EvanKrall/pipad/datasheets/GPIO - Raspberry Pi Documentation_files/octocat.jpg

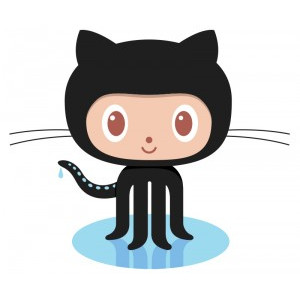
datasheets/GPIO - Raspberry Pi Documentation_files/octocat.jpg
