EvanKrall/pipad/(threads)

Thread 1 (2021-07-06):

bq25895 might negotiate high voltage USB, which would be passed through to RPi

EvanKrall, 2021-07-06:
Ideas:

- overvoltage protection on VBUS and/or PMID
- microcontroller that disables HVDCP_EN and MAXC_EN on power-up (possible race condition?)
- separate boost controller from battery (copy design from superpower-rpi)

EvanKrall, 2022-04-01:
fixed in cm4 branch; the radxa cm3 version uses the CM3's built-in battery charger (in theory)

Closed 2022-04-01.

Thread 2 (2021-07-06):

design: Flip touchscreen connectors and spread them apart

EvanKrall, 2021-07-06:
I need to mirror-image the touchscreen connectors front-to-back.

~They're also too close together by half a millimeter ish. I need to figure out exactly how far apart they need to be.~ Actually, looks like I soldered one of my connectors off-by-one.

EvanKrall, 2022-04-01:
fixed in both cm4 and radxa_cm3 branches.

Closed 2022-04-01.

Thread 6 (2021-07-06):

design: pull bq25895's OTG pin high

EvanKrall, 2021-07-06:
either with a trace or by connecting it to a microcontroller.

EvanKrall, 2021-07-21:
Only necessary if I keep using the bq25895's boost converter. If I switch to a separate boost converter to solve #1, then this isn't necessary.

Closed 2021-09-10.

Thread 7 (2021-07-06):

Assemble top of v0.0.1 prototype

EvanKrall, 2021-07-06:

EvanKrall, 2021-07-07:
I really should just pay to have boards assembled (or mostly assembled). 0402 is fiddly, tedious work.

Closed 2021-07-07.

Thread 8 (2021-07-06):

Test backlight controller

EvanKrall, 2021-07-06:
- [ ] Check open circuit voltage
- [x] Double check pinout
- [x] Test with dummy LED strings

EvanKrall, 2021-07-09:
Can't easily test open-circuit voltage because the tps61176 will shut down if it detects no LED strings.

EvanKrall, 2021-07-10:
Yep, the problem was the open circuit voltage not being high enough 🤦 https://hackaday.io/project/177256-put-a-raspberry-pi-cm4-into-an-original-ipad/log/195169-first-light-testing-and-fixing-the-backlight-controller

Closed 2021-07-10.

Thread 9 (2021-07-06):

design: wire up SDIO, power, i2s for wifi/bt controller

EvanKrall, 2021-07-06:

EvanKrall, 2021-09-10:
Honestly I should probably just get some extension cables for the wifi antennas and just get a cm4 with wifi/bt. Would take less effort and end up with faster wifi anyway.

Closed 2021-09-10.

Thread 12 (2021-07-07):

test new audio codec revision

EvanKrall, 2021-07-07:
Refer back to my project log about testing the last codec revision.

EvanKrall, 2021-09-18:
Some fun with the dtoverlay: https://www.raspberrypi.org/forums/viewtopic.php?p=1914969#p1914969

Today's task is to figure out why I'm not getting audio output. I can see i2s data being sent by the pi, and the headphone pins jump to some nonzero DC offset (which is odd... the whole point of switching to this codec was to get ground-centered headphone output.)

I think my plan here is to look at the datasheet, figure out what registers need to be set to what value to get output on HPL/HPR or LOL/LOR, and then see which settings in alsamixer affect those registers.

EvanKrall, 2021-09-18:
I think I forgot to connect ring2/GND_sense to ground.

EvanKrall, 2021-09-18:
I should rearrange the decoupling caps to put a 10uF near pin 39 (DVDD_CP).

EvanKrall, 2021-09-18:
oh, boo, the tlv320aic32x4 driver doesn't seem to know how to configure the charge pump in the 3206.

EvanKrall, 2021-09-18:
boo, it also doesn't seem to know how to configure the headset detection feature, page 0 reg 67. (2.11.1 Headset Detection in https://www.ti.com/lit/an/slaa463b/slaa463b.pdf)

EvanKrall, 2021-09-21:
Various registers to check:

- [ ] page 0 reg 4: xxxx0x11: MCLK or BCLK is PLL input; PLL clock is CODEC_CLKIN.
- [ ] page 0 reg 5: 1xxxxxxx: PLL is powered up
- [ ] page 0 reg 0x1b: 00xx00xx: i2s interface, bclk and wclk are inputs.
- [ ] page 0 reg 0x1d: xxx0xxxx: `0: No Loopback` (as opposed to `1: Stereo ADC output is routed to Stereo DAC input`)
- [ ] page 0 reg 0x25: 110x110x or 101x101x: LDAC/RDAC powered up and either LOL/LOR or HPL/HPR powered up.
- [ ] page 0 reg 0x2a: 00000000
- [ ] page 0 reg 0x2c: 000x00xx: no over-current problems. (Ignore headset insertion)
- [ ] page 0 reg 0x3f: 110101xx: DAC channels powered up, not disabled
- [ ] page 0 reg 0x40: x00000xx: auto mute disabled; neither channel muted
- [ ] page 0 reg 0x41: 0xxxxxxx: gain >= 0db (or at least not super low)
- [ ] page 0 reg 0x42: 0xxxxxxx: gain >= 0db (or at least not super low)
- [ ] page 1 reg 0x01: xxxxxx10 for charge pump (possibly not required)
- [ ] page 1 reg 0x02: xxxx11xx: analog blocks enabled; headphone driver powered up
- [ ] page 1 reg 0x09: xx110000 or xx001100: HPL/HPR are powered up and LOL/LOR/MAL/MAR are powered down, or LOL/LOR are powered up and HPL/HPR/MAL/MAR are powered down.
- [ ] page 1 reg 0x0c: xxxx1000: only left channel DAC is routed to HPL.
- [ ] page 1 reg 0x0d: xxx0100x: only right channel DAC is routed to HPR.
- [ ] page 1 reg 0x0e: xxx01x00: only left channel DAC is routed to LOL.
- [ ] page 1 reg 0x0f: xxxx1x0x: only right channel DAC is routed to LOR.
- [ ] page 1 reg 0x10: x0xxxxxx: HPL not muted.
- [ ] page 1 reg 0x11: x0xxxxxx: HPR not muted
- [ ] page 1 reg 0x12: x0xxxxxx: LOL not muted
- [ ] page 1 reg 0x13: x0xxxxxx: LOR not muted
- [ ] page 1 reg 0x16: x1110010: IN1L to HPL muted
- [ ] page 1 reg 0x17: x1110010: IN1R to HPR muted
- [ ] page 1 reg 0x18: xx101000 (MAL muted)
- [ ] page 1 reg 0x19: xx101000 (MAR muted)
- [ ] page 1 reg 0x3f: 11111111
- [ ] page 1 reg 0x7d: xxx1xxxx: enable ground-centered mode

Experiments:

- page 0 reg 0x1d: set d5 high: `Audio Data in is routed to Audio Data out`. See if it sends us valid data back.
- page 0 reg 0x47: generate a beep on left channel
- Maybe try configuring MFP5 or MISO or DOUT to pass CLKOUT to see if we have a valid clock internally?

EvanKrall, 2021-09-25:
I finally got audio by setting page 0 reg 0x04 to 0x01 (BCLK is CODEC_CLKIN), among some other settings.

By setting DOUT to CLKOUT, and CDIV_CLKIN to PLL_CLK, I could see that the PLL was not generating a clock.

EvanKrall, 2021-11-04:
with this script, I can get a steady 4xBCLK out of the PLL:

```
./tlv320aic32x6_set_reg.sh 0 0x04 0x07   # D6=0 low PLL clock range (?); D3..2 = 01 BCLK pin is input to PLL; D1..0 = 11: PLL clock is CODEC_CLKIN

# Page 77 in slaa463b.pdf
# PLL_CLK = (PLL_CLKIN * R * J.D) / P

./tlv320aic32x6_set_reg.sh 0 0x05 0x91  # PLL enabled (D7), configure P (D6..4) = 1 and R (D3..0) = 1 - page 96
./tlv320aic32x6_set_reg.sh 0 0x06 0x04  # PLL parameter J = 4
./tlv320aic32x6_set_reg.sh 0 0x07 0x00; ./tlv320aic32x6_set_reg.sh 0 0x08 0x00  # PLL parameter D = 0

# DOUT is CLKOUT
./tlv320aic32x6_set_reg.sh 0 0x35 0x16
# CLKOUT is PLL
./tlv320aic32x6_set_reg.sh 0 0x19 0x03
# CLKOUT powered up, divider = 1
./tlv320aic32x6_set_reg.sh 0 0x1A 0x81
```

There's a lot of white noise on the output, but it does work.

EvanKrall, 2021-11-04:
I think I left the headphone connector's ground pin (GND_SENSE) ungrounded. I wonder if this is why it seems to be also swinging around with the output signal, and things seem to get louder when one channel is muted.

EvanKrall, 2021-11-07:
Played around with enabling the charge pump tonight:

```

#####################################################
# Enabling the charge pump and ground-centered mode #
#####################################################

# To turn on the charge pump circuit, program Page 1, Register 1, D1:0 to “10”. When the charge pump
# circuit is disabled, VNEG acts as a ground terminal, allowing unipolar configuration of the headphone
# amps. By default, the charge pump is disabled.
./tlv320aic32x6_set_reg.sh 1 0x01 0x02  # D1-D0 = 10: Power Up Charge Pump with Internal Oscillator Clock (nom. 8MHz)

# The switching rate of the charge pump can be controlled
# by Page 1, Register 124, D3:0. Because the charge pump can demand significant inrush currents from the
# supply, it is important to have a capacitor connected in close proximity to the DVdd_CP and DVss_CP
# pins of the device. At 500kHz clock rate this requires approximately a 10μF capacitor. The ESR and ESL
# of the capacitor must be low to allow fast switching currents.
./tlv320aic32x6_set_reg.sh 1 0x7c 0x00  # Charge Pump Clock Divide Control = 64

# The ground-centered mode of operation is enabled by configuring Page 1, Reg 125, D4 after enabling the
# charge-pump.
./tlv320aic32x6_set_reg.sh 1 0x7d 0x13  # Enable Ground Centered Mode for Headphone Drivers; Output Power Rating is 100%; DC Offset Correction for all possible signal routings for HPL and HPR
```

I'm seeing significant droop on AVDD and DVDD_CP when audio levels get high; I may need to bump the size of the capacitors. In particular, slaa463b says I should have a 10uF cap on DVDD_CP, but I have 0.1uF.

Earlier in the day (when I was not using ground-centered mode), I had compared left and right channels against each other with an XY chart; this showed significant correlation between the two when playing silence. (With an interesting banding pattern which I think is due to dithering applied by the DAC.) I should do this again in ground-centered mode.

I should also try to measure the droop on the various Vcc pins.

EvanKrall, 2021-11-08:
By playing some white noise and looking at the FFT with my oscilloscope, it appears that the frequency response of the output drops off significantly from about 2.4kHz to 2.7kHz. I think I need to take a look at the various user-defined filters (slaa463b, page 44 and onwards).

I'm also still getting a lot of broad-spectrum noise mixed with my output signal. I'd like to get to the bottom of that. Based on how it looks on my scope (quantized), I think it may be added by codec as dithering, to reduce quantization error.

Thread 13 (2021-07-07):

design: wrong footprint on FSA2275

EvanKrall, 2021-07-07:
SnapEDA has the wrong footprint and I forgot to validate it before using.

Closed 2021-07-21.

Thread 14 (2021-07-07):

test touchscreen controller

EvanKrall, 2021-07-07:
- [ ] check if it enumerates on i2c
- [ ] write device tree overlay
- [ ] see if connectors can be inserted upside down (to work around #2 )
- [ ] ???

EvanKrall, 2022-04-03:
I need to wire up the INT pin to a GPIO :(

this is gonna be a fun bodge.

Thread 15 (2021-07-07):

test LVDS controller

EvanKrall, 2021-07-07:
- [ ] see if it enumerates on i2c
- [ ] Write device tree overlay
- [ ] figure out mode line?
- [ ] ???

EvanKrall, 2021-08-06:
For posterity, my attempt at a kernel patch to drive this thing:

```
diff --git a/drivers/gpu/drm/panel/panel-simple.c b/drivers/gpu/drm/panel/panel-simple.c
index 204674fccd64..eb1a5950247c 100644
--- a/drivers/gpu/drm/panel/panel-simple.c
+++ b/drivers/gpu/drm/panel/panel-simple.c
@@ -2570,15 +2570,15 @@ static const struct panel_desc lg_lp079qx1_sp0v = {
 };

 static const struct drm_display_mode lg_lp097qx1_spa1_mode = {
-       .clock = 205210,
-       .hdisplay = 2048,
-       .hsync_start = 2048 + 150,
-       .hsync_end = 2048 + 150 + 5,
-       .htotal = 2048 + 150 + 5 + 5,
-       .vdisplay = 1536,
-       .vsync_start = 1536 + 3,
-       .vsync_end = 1536 + 3 + 1,
-       .vtotal = 1536 + 3 + 1 + 9,
+       .clock = 205210,  // KHz
+       .hdisplay = 2048,  // Active
+       .hsync_start = 2048 + 150,  // Active + HFP
+       .hsync_end = 2048 + 150 + 5, // Active + HFP + Width-Active
+       .htotal = 2048 + 150 + 5 + 5, // Active + HFP + Width-Active + HBP
+       .vdisplay = 1536, // Active
+       .vsync_start = 1536 + 3, // Active + VFP
+       .vsync_end = 1536 + 3 + 1, // Active + VFP + Width-Active
+       .vtotal = 1536 + 3 + 1 + 9, // Active + VFP + Width-Active + VBP
 };

 static const struct panel_desc lg_lp097qx1_spa1 = {
@@ -3889,6 +3889,30 @@ static const struct drm_display_mode arm_rtsm_mode[] = {
        },
 };

+
+static const struct drm_display_mode lg_lp097x02_slq1_mode = {
+       .clock = 100030,  // KHz
+       .hdisplay = 1024,  // Active
+       .hsync_start = 1024 + 260,  // Active + HFP
+       .hsync_end = 1024 + 260 + 320, // Active + HFP + Width-Active
+       .htotal = 1024 + 260 + 320 + 480, // Active + HFP + Width-Active + HBP
+       .vdisplay = 768, // Active
+       .vsync_start = 768 + 16, // Active + VFP
+       .vsync_end = 768 + 16 + 10, // Active + VFP + Width-Active
+       .vtotal = 768 + 16 + 10 + 6, // Active + VFP + Width-Active + VBP
+};
+
+static const struct panel_desc lg_lp097x02_slq1 = {
+       .modes = &lg_lp097qx1_spa1_mode,
+       .num_modes = 1,
+       .size = {
+               .width = 210,
+               .height = 164,
+       },
+};
+
+
+
 static const struct panel_desc arm_rtsm = {
        .modes = arm_rtsm_mode,
        .num_modes = 1,
@@ -4300,6 +4324,9 @@ static const struct of_device_id platform_of_match[] = {
        }, {
                .compatible = "winstar,wf35ltiacd",
                .data = &winstar_wf35ltiacd,
+       }, {
+               .compatible = "lg,lp097x02-slq1",
+               .data = &lg_lp097x02_slq1,
        }, {
                /* Must be the last entry */
                .compatible = "panel-dpi",
```

I'm roughly following https://github.com/anholt/linux/wiki/Raspberry-Pi-and-other-MIPI-DSI-display-panels , though I'm first starting with `panel-simple.c` even though I have a bridge chip and it recommends to follow the `panel-raspberrypi-touchscreen.c` example.

EvanKrall, 2021-08-06:
oh, sweet, someone got support for the sn65dsi83 into the linux kernel a few months ago: https://github.com/torvalds/linux/blob/master/drivers/gpu/drm/bridge/ti-sn65dsi83.c

I guess I'll cherry-pick this.

EvanKrall, 2021-08-06:
> Only RGB888 pixel format is implemented, the
> LVDS666 is not supported, but could be added if needed.

bummer

EvanKrall, 2021-08-22:
I have this dtoverlay which loads the ti-sn65dsi83 driver:

```
/dts-v1/;
/plugin/;

/ {
    compatible = "brcm,bcm2835";
    fragment@0 {
        target-path = "/";
        __overlay__ {
            vdd_panel: fixedregulator {
                regulator-boot-on;
                compatible = "regulator-fixed";
                regulator-name = "lvds18";
                regulator-min-microvolt = <1800000>;
                regulator-max-microvolt = <1800000>;
                gpio = <&gpio 26 0>;
                startup-delay-us = <70000>;
                enable-active-high;
                vin-supply = <&vdd_3v3_reg>;
            };

            lcd_bl: backlight {
                compatible = "pwm-backlight";
                pwms = <&pwm 0 200000>;
                brightness-levels = <0 6 8 12 16 24 32 40 48 64 96 128 160 192 224 255>;
                default-brightness-level = <6>;
                power-supply = <&vdd_3v3_reg>;
                enable-gpios = <&gpio 13 0>;
                status = "okay";
            };

            panel_rgb: panel {
              compatible = "lg,lp097x02-slq1";
              // compatible = "koe,tx31d200vm0baa";
              power-supply = <&vdd_panel>;
              // backlight = <&lcd_bl>;
              status = "okay";
              port {
                panel_lvds_in: endpoint {
                  remote-endpoint = <&bridge_lvds_port>;
                };
              };
            };
        };
    };

    fragment@1 {
        target = <&i2c1>;
        __overlay__ {
            #address-cells = <1>;
            #size-cells = <0>;
            status = "okay";

            sn65dsi83_bridge: bridge@2d {
                compatible = "ti,sn65dsi83";
                reg = <0x2d>;
                status = "okay";
                enable-gpios = <&gpio 5 0>;
                power-supply = <&vdd_panel>;

                ports {        
                    #address-cells = <1>;
                    #size-cells = <0>;
                    port@0 {
                        reg = <0>; // TODO: double-check
                        bridge_dsi_port: endpoint {
                            data-lanes = <1 2>;
                            remote-endpoint = <&dsi_out_port>;
                        };
                    };

                    port@2{
                        reg = <2>;
                        bridge_lvds_port: endpoint {
                            remote-endpoint = <&panel_lvds_in>;
                        };
                    };
                };
            };
        };
    };

    fragment@2 {
        target = <&dsi1>;
        __overlay__ {
            compatible = "brcm,bcm2711-dsi1";
            status = "okay";
            port {
                dsi_out_port: endpoint {
                    remote-endpoint = <&bridge_dsi_port>;
                };
            };
        };
    };
};
```

I've got two problems at the moment:
1. My backlight lights up, but I don't have any entries under /sys/class/backlight
2. The screen is black, and at boot I'm getting the error message ```[    5.403630] sn65dsi83 1-002d: failed to lock PLL, ret=-110```

EvanKrall, 2021-08-22:
I've switched over to the CM4IO using the 22-pin to 15-pin FFC meant for the CSI port, which I think should put clock and data lanes where my board expects them.

Now I'm getting basically this exact error: https://www.raspberrypi.org/forums/viewtopic.php?p=1860828&sid=ad26a9c56f475f1c54610b6eac4ca59f#p1860828

```
[    5.325798] Bogus possible_crtcs: [ENCODER:31:DSI-31] possible_crtcs=0x0 (full crtc mask=0x1)
```

Thread 17 (2021-07-09):

design: don't need to run VCC3.3 on F.Cu

EvanKrall, 2021-07-09:
there's a long 0.5mm VCC3.3 trace on the front layer going up to the gt9113 and down to the tca9802 near the ALS port. There's no need for that - we have VCC3.3 on In1 near both of those.

EvanKrall, 2021-07-21:
fixed sometime between 19297b17f33d9973a65e6c52b8320bec698a0743 and 6ebf38a58aa911a66509f7bd489c938d12b0aee5

Closed 2021-07-21.

Thread 18 (2021-07-11):

design: prototype board DSI connector has i2c on wrong pins

EvanKrall, 2021-07-11:
I've got sda on 13 and scl on 14, but it should be 11 for scl, 12 for sda I think?

EvanKrall, 2021-07-12:
Also seems backwards.

EvanKrall, 2022-04-01:
irrelevant now that I've redesigned the boards for cm4/radxa cm3

Closed 2022-04-01.

Thread 20 (2021-07-18):

design: add M.2 slot for NVME drive

EvanKrall, 2021-07-18:

EvanKrall, 2021-07-22:
https://global.kyocera.com/prdct/electro/product/pdf/6411.pdf kyocera has a 2.25mm socket: https://www.digikey.com/en/products/detail/246411067101894B/1253-1602-1-ND/5814321?itemSeq=371692007

EvanKrall, 2021-07-22:
oops I probably would want the M key socket, not the B key. (Even though the SN520 I bought is B+M keyed, most NVMe drives are only M key.)

https://www.digikey.com/en/products/detail/kyocera-international-inc-electronic-components/246411067101894M/5814311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

EvanKrall, 2021-07-22:
https://github.com/mfolejewski/MirkoPC/blob/81a24fadfe165a523ffb9167838d34fb3440f881/REV1.1/MirkoPC_V1R2_Schematic_20210507.pdf Sheet 8 of 17 shows the schematic for the M.2 connector on the MirkoPC, which has well-tested NVMe boot capability.

EvanKrall, 2021-07-22:
The MirkoPC provides its own 3.3V rail for the NVMe drive. Probably a wise choice - the SN520 claims to use up to 3W (1A), but I think other drives might be able to pull more.

EvanKrall, 2021-07-22:
Jeff Geerling's experience with the SN520: https://github.com/geerlingguy/raspberry-pi-pcie-devices/issues/90

EvanKrall, 2021-08-31:
The next challenge is where to find the solder-down standoffs. I think this is the appropriate standard to follow (from the m.2 specification):
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

EvanKrall, 2021-08-31:
I think this is the right standoff/nut: https://www.mouser.com/ProductDetail/JAE-Electronics/SM3ZS067U215-NUT1-R2500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

EvanKrall, 2022-04-01:
this is added in both the cm4 and radxa_cm3 branches

Closed 2022-04-01.

Thread 22 (2022-04-01):

Figure out what's up with the Radxa CM3 battery charger circuitry

EvanKrall, 2022-04-01:
- If I have a battery connected, do I need to power the 5v inputs?
- how does the USB_OTG0_VBUSDET pin work?
- Can the CM3 actually charge a battery from USB?
- Can the CM3 actually run from battery?
- Can it handle hot plugging USB in and out?

Thread 24 (2022-06-27):

max16150 times out before nEXTRST goes high

EvanKrall, 2022-06-27:
the MAX16150 I'm using to handle the power button logic gives you 64ms for its `~CLR` line to go high before it gives up and shuts off the power again -- the CM4's nEXTRST line doesn't go high soon enough.

best ways I can think of to work around this:

- Use a voltage divider to bring 5v down to 3.3V, then also wire a GPIO to this 3.3V node. Use the [gpio-poweroff](https://www.kernel.org/doc/Documentation/devicetree/bindings/power/reset/gpio-poweroff.txt) dtoverlay to pull that GPIO low on shutdown.
- check whether the 3.3V or 1.8V lines go high soon enough, use those instead
- 555 timer or similar in one-shot mode, pulling the ~CLR pin high for longer?

Thread 25 (2022-06-27):

Wire nRPIBOOT to a button, figure out how to use nRPIBOOT as GPIO

EvanKrall, 2022-06-27:
I'm pretty sure I saw something that suggested that nRPIBOOT is just a regular GPIO internally, so we can kill two birds with one stone by wiring nRPIBOOT to a button (maybe volume down?)

- have a button that allows us to force rpiboot mode
- free up a GPIO for other uses (e.g. #24)

EvanKrall, 2022-06-27:
https://www.alexwhittemore.com/raspberry-pi-cm4-using-nrpi_boot/

Thread 28 (2022-09-08):

(Feature Request) Support for Radxa CM5

kerta1n, 2022-09-08:
Hello, with the upcoming [CM5](https://www.cnx-software.com/2022/09/08/radxa-cm5-rockchip-rk3588s-module-raspberry-pi-cm4/) board with a RK3588S (which is an Octa-core CPU), would all of the I/O on this PCB be compatible if someone wants to use this as a faster replacement to the RPi CM4?
edit: spelling mistake

EvanKrall, 2022-09-08:
In theory, yes, as long as the pins are in compatible locations.

I'm using the majority of the pins as low speed GPIO (interrupts and enable pins and such), I wouldn't be too concerned with those.

the special-purpose pins I'm using are:
- i2c
- I2s
- PWM (for LCD backlight)
- PCIe, but this is optional if you use built-in eMMC
- DSI
- USB

I do also have a branch (radxa_cm3) specifically designed for the Radxa CM3, which takes advantage of the fact that the CM3 can output LVDS signals directly, and avoids the need for the DSI-LVDS bridge. It doesn't look like the CM5 can do LVDS, so one would need to start from the cm4 branch.

Also it looks like the CM5 doesn't have wifi, so I'd need to figure out the iPad's built in wifi chip to have networking. (Currently I'm just relying on the cm4's built-in wifi)

If you're planning on ordering a copy of this board, I wouldn't really recommend it. It's very much a work in progresss. I've still got several issues to work out, the biggest of which is getting the screen to work. I've been posting updates to https://hackaday.io/project/177256-put-a-raspberry-pi-cm4-into-an-original-ipad (but I'm currently stuck on getting the LVDS bridge to cooperate)

kerta1n, 2022-09-12:
That makes a lot more sense. Thank you!

Closed 2022-09-12.

Thread 29 (2023-04-08):

NVMe slot not working

EvanKrall, 2023-04-08:
```
meatmanek@cm4:/sys/bus/pci$ dmesg | grep pcie
[    5.270094] calling  brcm_pcie_driver_init+0x0/0x30 @ 1
[    5.275937] brcm-pcie fd500000.pcie: host bridge /scb/pcie@7d500000 ranges:
[    5.283029] brcm-pcie fd500000.pcie:   No bus range found for /scb/pcie@7d500000, using [bus 00-ff]
[    5.292278] brcm-pcie fd500000.pcie:      MEM 0x0600000000..0x063fffffff -> 0x00c0000000
[    5.300556] brcm-pcie fd500000.pcie:   IB MEM 0x0000000000..0x003fffffff -> 0x0400000000
[    5.629281] brcm-pcie fd500000.pcie: link down
[    5.633953] initcall brcm_pcie_driver_init+0x0/0x30 returned 0 after 350140 usecs
```

[this forum post](https://forums.raspberrypi.com/viewtopic.php?p=2065042#p2065042) suggests that this is likely a PCIe connection issue.

I had discovered that my TX and RX lanes were swapped, so I made an interposer board that swaps them, but this didn't help. Perhaps I need AC coupling capacitors? CM4 docs suggest that the CM4 has AC coupling capacitor for its TX lines, and that PCIe cards should come with AC coupling capacitors. Does that apply to M.2 cards, or does my carrier board need to include them?

EvanKrall, 2023-04-08:
- [ ] nvme drive works in usb-nvme adapter
- [ ] nvme drive works in pcie-nvme adapter with cm4 on cm4io board
- [ ] optical inspection of solder joints on cm4 connector
- [ ] optical inspection of solder joints on m.2 connector on pipad
- [ ] optical inspection of solder joints on m.2 connector on interposer board

EvanKrall, 2023-04-08:
refclk pins are shorted on interposer board

EvanKrall, 2023-04-08:
ok, fixed the short on the interposer board, but still getting the same link down / empty lspci behavior

EvanKrall, 2023-04-09:
Ok, turns out one of the RX pins wasn't soldered on the cm4 connector.

Closed 2023-04-09.
