EvanKrall/pipad/cm4_ipad_display_adapter.kicad_pcb

## KiCad design cm4_ipad_display_adapter.kicad_pcb (2021-04-06)

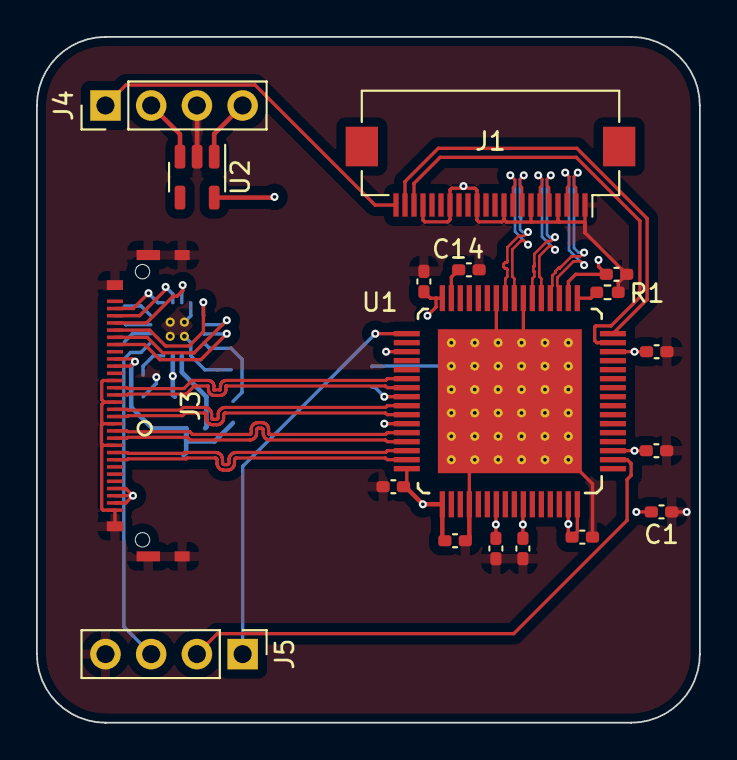
[picture p12: board cm4_ipad_display_adapter.kicad_pcb from above]

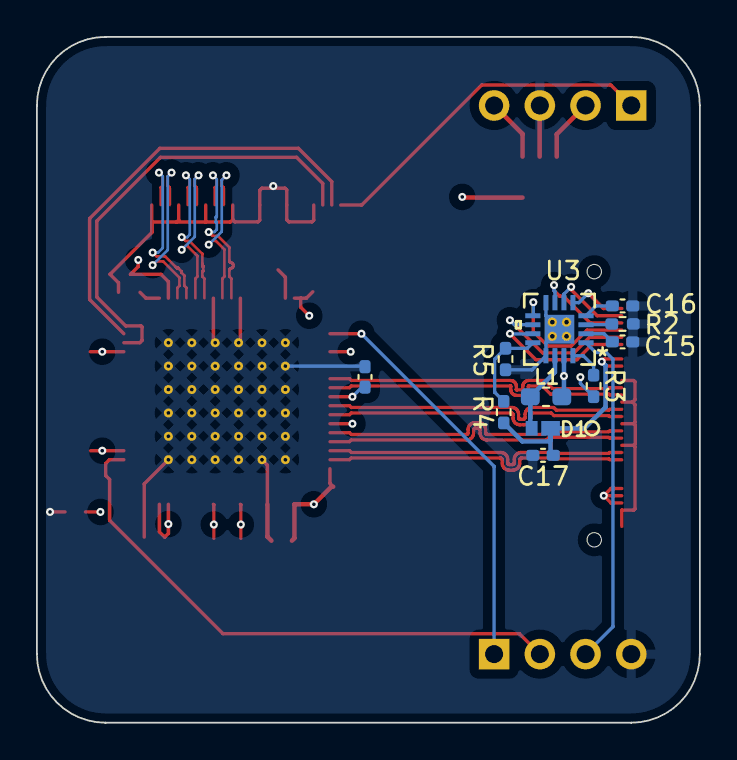
[picture p13: board cm4_ipad_display_adapter.kicad_pcb from below]

Board: 4 copper layers, 36.8 x 38.1 mm, 29 parts (11 on the bottom side), 39 nets.

Parts:
C1: 10uF; C_0402_1005Metric_Pad0.74x0.62mm_HandSolder
C2, C4, C5, C6, C7, C8, C9, C11, C12, C13: 100nF; C_0402_1005Metric_Pad0.74x0.62mm_HandSolder
C14, C15: 1uF; C_0402_1005Metric_Pad0.74x0.62mm_HandSolder
C16: 0.47uF; C_0402_1005Metric_Pad0.74x0.62mm_HandSolder
C17: 4.7uF; C_0402_1005Metric_Pad0.74x0.62mm_HandSolder
D1: D_Schottky; PMEG4010EPK_315
J1: Conn_01x22_Female; Hirose_FH12-22S-0.5SH_1x22-1MP_P0.50mm_Horizontal
J3: Conn_01x34_Female; 20474-030E-11
J4: Conn_01x02_Female; PinHeader_1x04_P2.54mm_Vertical
J5: Conn_01x04_Female; PinHeader_1x04_P2.54mm_Vertical
L1: 4.7uH; L_0603_1608Metric_Pad1.05x0.95mm_HandSolder
R1: 10k; R_0402_1005Metric_Pad0.72x0.64mm_HandSolder
R2: 53.6k; R_0402_1005Metric_Pad0.72x0.64mm_HandSolder
R3: 1.3M; R_0402_1005Metric_Pad0.72x0.64mm_HandSolder
R4: 1M; R_0402_1005Metric_Pad0.72x0.64mm_HandSolder
R5: 143k; R_0402_1005Metric_Pad0.72x0.64mm_HandSolder
U1: SN65DSI83TPAPRQ1
U2: MIC5504-1.8YM5; SOT-23-5
U3: TPS61176RTER

Connections:
/LVDS/CLKIN+: J3.18, U1.38 (A_CLKP)
/LVDS/CLKIN-: J3.17, U1.39 (A_CLKN)
/LVDS/DSI0_C_N: J1.8, U1.25 (DACN)
/LVDS/DSI0_C_P: J1.9, U1.24 (DACP)
/LVDS/DSI0_D0_N: J1.2, U1.20 (DA0N)
/LVDS/DSI0_D0_P: J1.3, U1.19 (DA0P)
/LVDS/DSI0_D1_N: J1.5, U1.22 (DA1N)
/LVDS/DSI0_D1_P: J1.6, U1.21 (DA1P)
/LVDS/IRQ: J5.1, U1.33 (IRQ)
/LVDS/LED_ANODE: C17.1, D1.1, J3.21, J3.22, R4.1
/LVDS/LED_CATHODE1: J3.24, U3.11 (IFB1)
/LVDS/LED_CATHODE2: J3.25, U3.10 (IFB2)
/LVDS/LED_CATHODE3: J3.26, U3.9 (IFB3)
/LVDS/LED_CATHODE4: J3.27, U3.7 (IFB4)
/LVDS/LED_CATHODE5: J3.28, U3.6 (IFB5)
/LVDS/LED_CATHODE6: J3.29, U3.5 (IFB6)
/LVDS/RIN0+: J3.9, U1.46 (A_Y0P)
/LVDS/RIN0-: J3.8, U1.47 (A_Y0N)
/LVDS/RIN1+: J3.12, U1.44 (A_Y1P)
/LVDS/RIN1-: J3.11, U1.45 (A_Y1N)
/LVDS/RIN2+: J3.15, U1.41 (A_Y2P)
/LVDS/RIN2-: J3.14, U1.42 (A_Y2N)
/LVDS/SCL1: J1.20, U1.15 (SCL)
/LVDS/SDA1: J1.21, U1.16 (SDA)
/LVDS/SN65DSI83_EN: J5.2, U1.2 (EN)
GND: C1.2, C2.2, C4.2, C5.2, C6.2, C7.2, C8.2, C9.2, C11.2, C12.2, C13.2, C14.2, C15.2, C16.2, C17.2, J1.1, J1.4, J1.7, J1.10, J1.13, J1.16, J1.19, J3.1, J3.10, J3.13, J3.16, J3.19, J3.31, J3.32, J4.3, J5.4, R1.2, R2.2, R3.2, R5.2, U1.23 (GND), U1.26 (GND), U1.52 (GND), U1.65 (PAD), U2.2 (GND), U3.8 (GND), U3.13 (PGND), U3.17 (EPAD)
LDO_EN: J4.2, U2.3 (EN)
unnamed: C14.1, U1.31 (VCORE)
unnamed: C15.1, U3.2 (VLDO)
unnamed: C16.1, U3.4 (COMP)
unnamed: D1.2, L1.2, U3.14 (SW)
unnamed: R1.1, U1.17 (REFCLK)
unnamed: R2.1, U3.3 (ISET)
unnamed: R3.1, U3.16 (MODE/FAULT)
unnamed: R4.2, R5.1, U3.12 (OVP)
PWM: J5.3, U3.1 (PWM/EN)
VBAT: J4.4, L1.1, U2.1 (VIN), U3.15 (VIN)
VCC_1.8: C1.1, C2.1, C4.1, C5.1, C6.1, C7.1, C8.1, C9.1, C11.1, C12.1, C13.1, U1.3 (VCC), U1.14 (VCC), U1.18 (VCC), U1.32 (VCC), U1.35 (VCC), U1.40 (VCC), U1.43 (VCC), U1.48 (VCC), U1.49 (VCC), U1.55 (VCC), U1.58 (VCC), U1.63 (VCC), U1.64 (ADDR), U2.5 (VOUT)
VCC_3.3: J1.22, J3.2, J3.3, J3.4, J4.1
