EvanKrall/pipad/(commit log)

2021-02-04 Finally put this stuff in git
    [atmxt2952td breakout.kicad_pcb, atmxt2952td breakout.sch]
2021-02-04 Set up some github actions for making gerbers and rendering the board
2021-02-04 refill filled zones
    [atmxt2952td breakout.kicad_pcb]
2021-02-05 Put gerbers into release artifacts so that they're stored more permanently.
2021-02-05 Create release first, then have gerbers/plot jobs upload assets into the release.
2021-02-05 Move silkscreen references around so they're visible
    [atmxt2952td breakout.kicad_pcb]
2021-02-05 Add a bare copper area on the edge of the back, to provide a low-impedance ground that can eventually be connected to the chassis.
    [atmxt2952td breakout.kicad_pcb]
2021-02-12 Initial commit: empty project and some github actions from atmxt2952 breakout project
    [i2s_soundcard.kicad_pcb, i2s_soundcard.sch]
2021-02-12 Add some footprints
2021-02-12 schematic: add codec, 2x (amplifier, switch)
    [i2s_soundcard.sch, spkr_amp.sch]
2021-02-12 schematic: Add speaker connector
    [i2s_soundcard.sch]
2021-02-12 schematic: wire up most of the headphone jack
    [i2s_soundcard.sch]
2021-02-12 Import FSA2275 footprint from SnapEDA; annotate symbols.
    [i2s_soundcard.sch, spkr_amp.sch]
2021-02-15 Import logic board outline and cutout for touchscreen controller, start layout.
    [i2s_soundcard.kicad_pcb]
2021-02-16 Lots more routing; set V pads on TPA2006 to GND; add 1.8V/3.3V dual LDO: TLV7111830. Save datasheets to project directory for safe keeping.
    [i2s_soundcard.kicad_pcb, i2s_soundcard.sch, spkr_amp.sch]
2021-02-16 Break out more nets to pins, move switches down to make room for those traces. Reroute a lot of things.
    [i2s_soundcard.kicad_pcb, i2s_soundcard.sch, spkr_amp.sch]
2021-02-16 Tweak ground planes a bit.
    [i2s_soundcard.kicad_pcb]
2021-02-16 Drop clearance requirements and move vias/ground planes around to make DRC happy.
    [i2s_soundcard.kicad_pcb]
2021-02-16 Clean up silkscreen, add some silkscreen labels to pin headers.
    [i2s_soundcard.kicad_pcb]
2021-02-17 Add TVS diodes on all the headphone port pins
    [i2s_soundcard.kicad_pcb, i2s_soundcard.sch, spkr_amp.sch]
2021-02-17 Rearrange pin headers to be on 1mm grid relative to each other
    [i2s_soundcard.kicad_pcb]
2021-02-17 adjust vbat fill so that it isn't missing a corner
    [i2s_soundcard.kicad_pcb]
2021-02-17 fill in rest of in2 with ground fill
    [i2s_soundcard.kicad_pcb]
2021-02-17 Tidy up schematic a bit
    [i2s_soundcard.kicad_pcb, i2s_soundcard.sch, spkr_amp.sch]
2021-02-17 rename plot action to pcbdraw
2021-02-17 Github action for generating PDF of schematic
2021-02-18 Fix ERC errors by adjusting pin types and adding power flags as necessary.
    [i2s_soundcard.sch]
2021-02-18 Capitalize net names
    [i2s_soundcard.kicad_pcb, i2s_soundcard.sch]
2021-02-18 Rearrange pins on codec, TVS diodes, clean up schematic a bit.
    [i2s_soundcard.sch]
2021-02-18 Lots of schematic cleanup and board tweaking
    [i2s_soundcard.kicad_pcb, i2s_soundcard.sch, spkr_amp.sch]
2021-02-19 AC-couple headphone outputs. This frees up HPRCOM and HPLCOM, which I can use for line outputs, since the dock line out is single-ended anyway.
    [i2s_soundcard.kicad_pcb, i2s_soundcard.sch, spkr_amp.sch]
2021-02-20 Shrink board
    [i2s_soundcard.kicad_pcb]
2021-02-23 Clean up silkscreen a bit
    [i2s_soundcard.kicad_pcb]
2021-02-23 more silkscreen cleanup
    [i2s_soundcard.kicad_pcb]
2021-02-24 fork atmxt2952 breakout repo for switch to GT9113. Save some datasheets.
    [gt9113_breakout.kicad_pcb, gt9113_breakout.sch]
2021-02-24 Remove all traces of atmxt2952. enable pth_and_npth_single_file since that's what jlcpcb wants
2021-02-24 Create symbol for GT9113, add it to schematic and attach X0..39 and Y0..29 labels
    [gt9113_breakout.sch]
2021-02-24 Add footprint for GT9113. Start to route the drive/sense pins.
    [gt9113_breakout.kicad_pcb, gt9113_breakout.sch]
2021-02-25 Fix up USB connector footprint so I don't have to ignore DRC errors. Add courtyard for gt9113 footprint. Wire up digital IO pins to 2.54mm header. Tweak X/Y traces.
    [gt9113_breakout.kicad_pcb, gt9113_breakout.sch]
2021-02-25 Look for combined drill file
2021-02-27 Specify values of capacitors
    [i2s_soundcard.kicad_pcb, i2s_soundcard.sch]
2021-02-27 Change C2/C3 to 1206, adjust board to make that fit. Add courtyard to ESD protection diodes
    [i2s_soundcard.kicad_pcb, i2s_soundcard.sch]
2021-03-02 Most of LVDS converter wired up and routed; still need to finish design of LED driver.
    [cm4_ipad_display_adapter.kicad_pcb, cm4_ipad_display_adapter.kicad_sch, cm4_ipad_display_adapter.sch, displayport.kicad_sch, lvds.kicad_sch]
2021-03-02 LED driver: Set max voltage to 12V with 1M/143K divider on OVP pin; set full-scale current to 20mA with 53.6K resistor on ISET. Choose dimming mode 1 with 1.3M resistor to ground on mode/fault.
    [cm4_ipad_display_adapter.kicad_sch, lvds.kicad_sch]
2021-03-03 Fix ERC errors
    [cm4_ipad_display_adapter.kicad_sch, lvds.kicad_sch]
2021-03-03 Set values for remaining things; choose schottky diode model.
    [cm4_ipad_display_adapter.kicad_pcb, cm4_ipad_display_adapter.kicad_sch, lvds.kicad_sch]
2021-03-03 Add footprints for LED driver HEAD associated components, route them. Fix DRC issues, and add an edge cut.
    [cm4_ipad_display_adapter.kicad_pcb, cm4_ipad_display_adapter.kicad_sch]
2021-03-03 rearrange J4 pins to make traces for LDO simpler.
    [cm4_ipad_display_adapter.kicad_pcb, cm4_ipad_display_adapter.kicad_sch, lvds.kicad_sch]
2021-03-30 Some dtoverlay changes that make it actually load a driver.
2021-03-30 Convert to kicad 5.99 format
    [i2s_soundcard.kicad_sch, spkr_amp.kicad_sch]
2021-03-30 Schematic: switch to AIC3206 to get ground-centered headphone outputs, and just wire up directly to a raspberry pi 40-pin header instead of using 1mm headers.
    [i2s_soundcard.kicad_sch, spkr_amp.kicad_sch]
2021-04-03 lay out new version with AIC3206 codec
    [i2s_soundcard.kicad_pcb, i2s_soundcard.kicad_sch, spkr_amp.kicad_sch]
2021-04-04 Add an audio switch back in. Finish layout.
    [i2s_soundcard.kicad_pcb, i2s_soundcard.kicad_sch]
2021-04-04 Add 27R resistors to transmit side of i2s lines as recommended by aic3206 datasheet.
    [i2s_soundcard.kicad_pcb, i2s_soundcard.kicad_sch]
2021-04-05 Refactor everything but headers into a hierarchical sheet.
    [codec_and_amp.kicad_sch, i2s_soundcard.kicad_pcb, i2s_soundcard.kicad_sch, spkr_amp.kicad_sch]
2021-04-05 Finish porting to kicad v5.99 format
    [i2s_soundcard.kicad_sch, i2s_soundcard.sch, spkr_amp.kicad_sch, spkr_amp.sch]
2021-04-05 Fork i2s_soundcard project in preparation for merging other parts in.
    [pipad.kicad_pcb, pipad.kicad_sch]
2021-04-05 refactor gt9113_breakout into hierarchical sheet.
    [gt9113_breakout.kicad_sch, pipad.kicad_sch]
2021-04-05 Connect touchscreen controller to 40-pin header
    [pipad.kicad_pcb]
2021-04-06 Move everything for better alignment with 0.1mm grid; Add battery contact cutout and mounting holes
    [pipad.kicad_pcb]
2021-04-06 Import LVDS schematic as hierarchical sheet. Add level shifters for I2C and EN/IRQ pins.
    [lvds.kicad_sch, pipad.kicad_sch, spkr_amp.kicad_sch]
2021-04-06 Import cm4_ipad_display_adapter.kicad_pcb into pipad.kicad_pcb, redraw LVDS diff pairs.
    [lvds.kicad_sch, pipad.kicad_pcb, pipad.kicad_sch]
2021-04-08 Add dock connector, battery pads, and ambient light sensor/compass connector. Switch Pi GPIO header from from THT to SMT so it is easier to place/route. Route differential signals for LVDS converter.
    [als.kicad_sch, battery_charger.kicad_sch, dock_conn.kicad_sch, lvds.kicad_sch, pipad.kicad_pcb, pipad.kicad_sch, spkr_amp.kicad_sch]
2021-04-09 Change DSI connector to the 15-pin standard instead of 22-pin standard
    [codec_and_amp.kicad_sch, lvds.kicad_sch, pipad.kicad_pcb, pipad.kicad_sch]
2021-04-16 Add pinouts for dock connector; rearrange LCD backlight driver; copy the bq25895 schematic from SuperPower-RPi and add schottky to support 3.1A output on PMID.
    [battery_charger.kicad_sch, dock_conn.kicad_sch, lvds.kicad_sch, pipad.kicad_pcb, pipad.kicad_sch]
2021-04-16 update schema filename for kicad-exports workflow
2021-04-21 Wire more things up, move charger around.
    [als.kicad_sch, dock_conn.kicad_sch, gt9113_breakout.kicad_sch, lvds.kicad_sch, pipad.kicad_pcb, pipad.kicad_sch]
2021-05-04 Switch some footprints to minimize BOM costs. Cache a bunch more datasheets and documentation
    [als.kicad_sch, battery_charger.kicad_sch, codec_and_amp.kicad_sch, dock_conn.kicad_sch, gt9113_breakout.kicad_sch, lvds.kicad_sch, pipad.kicad_pcb, pipad.kicad_sch]
2021-05-28 Fix (or ignore) all ERC and DRC errors.
    [als.kicad_sch, dock_conn.kicad_sch, gt9113_breakout.kicad_sch, lvds.kicad_sch, pipad.kicad_pcb, pipad.kicad_sch]
2021-06-01 Fix more ERC errors
    [pipad.kicad_pcb, spkr_amp.kicad_sch]
2021-06-01 Replace TLV7111830 with MIC5504, since I wasn't using that VCC3.0 and the tlv7111830 is out of stock.
    [codec_and_amp.kicad_sch, pipad.kicad_sch]
2021-06-01 Fill in In2.Cu with ground plane anywhere we don't have power planes.
    [pipad.kicad_pcb]
2021-06-02 Clean up silkscreen
    [pipad.kicad_pcb]
2021-06-20 add usb otg connector for testing usb wiring; fix more ERC/DRC
    [codec_and_amp.kicad_sch, pipad.kicad_pcb, pipad.kicad_sch]
2021-06-21 Final tweaks before ordering.
    [pipad.kicad_pcb, pipad.kicad_sch]
2021-07-10 Change R18 to 82k so LCD backlight controller can be up to 19.8V, instead of 12V. Add script for reading and parsing bq25895 registers. Add datasheets for samsung-produced LCD panels.
    [lvds.kicad_sch, pipad.kicad_sch, spkr_amp.kicad_sch]
2021-07-19 idk, some random file changes kicad made for me.
2021-07-21 Fix footprint for FSA2275. Fixes #13
    [lvds.kicad_sch, pipad.kicad_pcb, spkr_amp.kicad_sch]
